HelsinkiHacklab/HugeLedMatrix/KiCad/Absen/physical.dxf

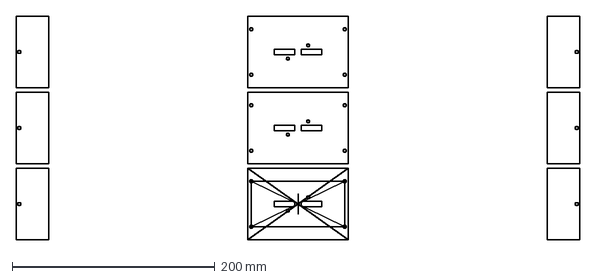
[picture p1: CAD file, 2018-04-18]
KiCad/Absen/physical.dxf
556.0 x 220.4 mm
