HelsinkiHacklab/HugeLedMatrix/KiCad/Absen/absen.pdf

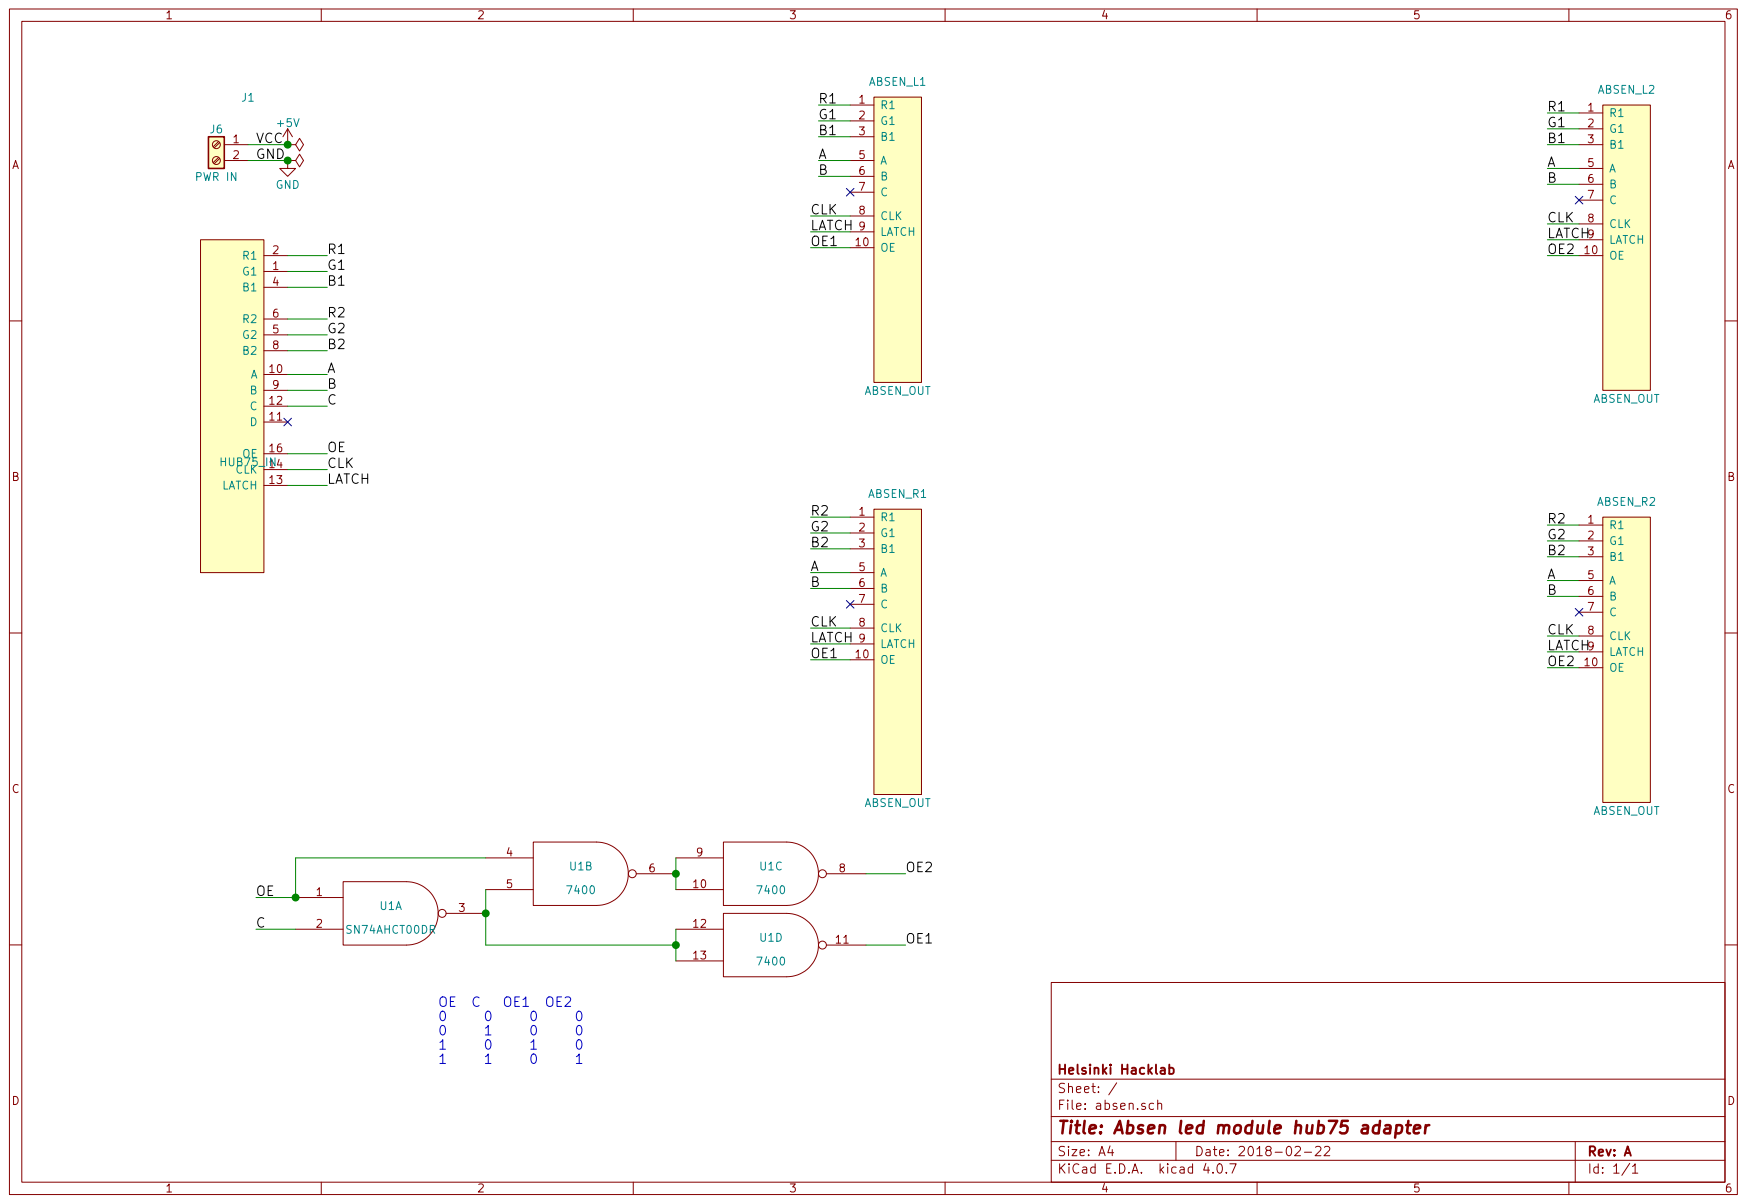
[picture p2: page 1]
