HelsinkiHacklab/HugeLedMatrix/KiCad/Absen/absen.kicad_pcb

## KiCad design KiCad/Absen/absen.kicad_pcb (2018-04-18)

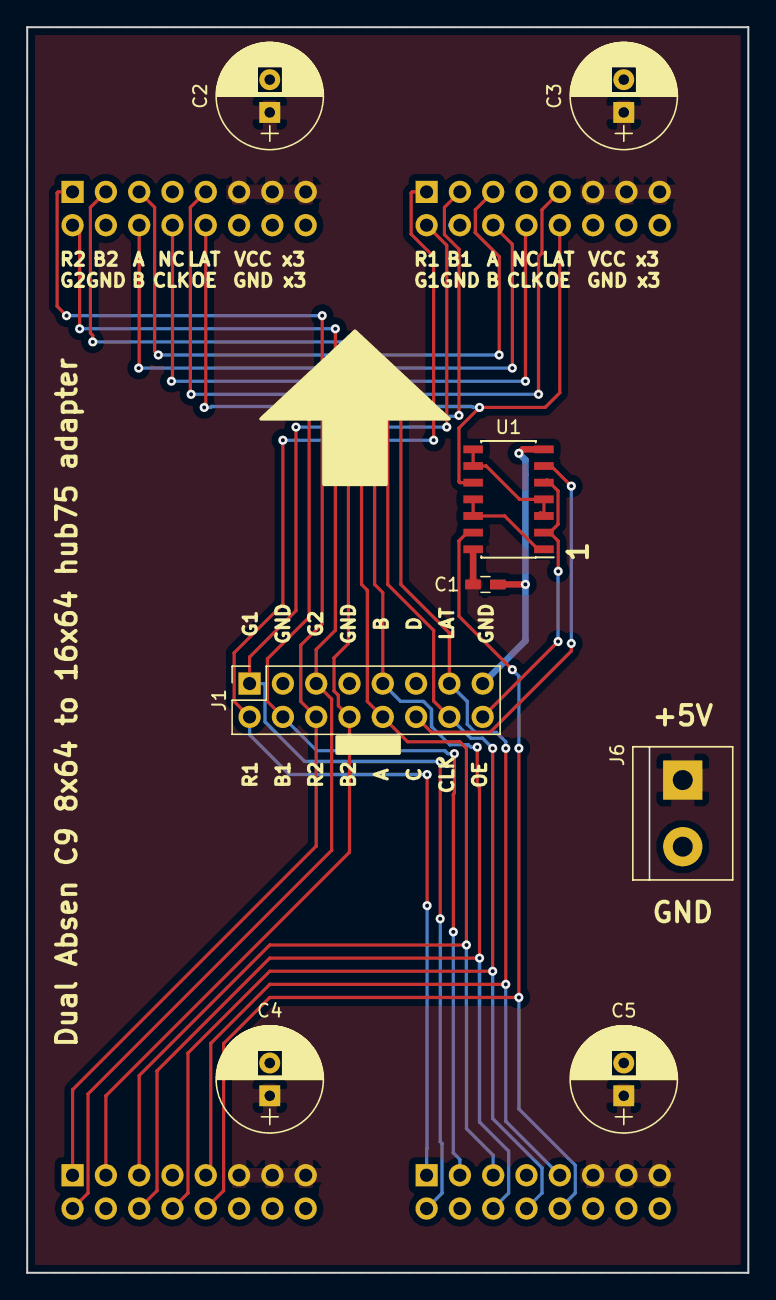
[picture p3: board absen.kicad_pcb from above]

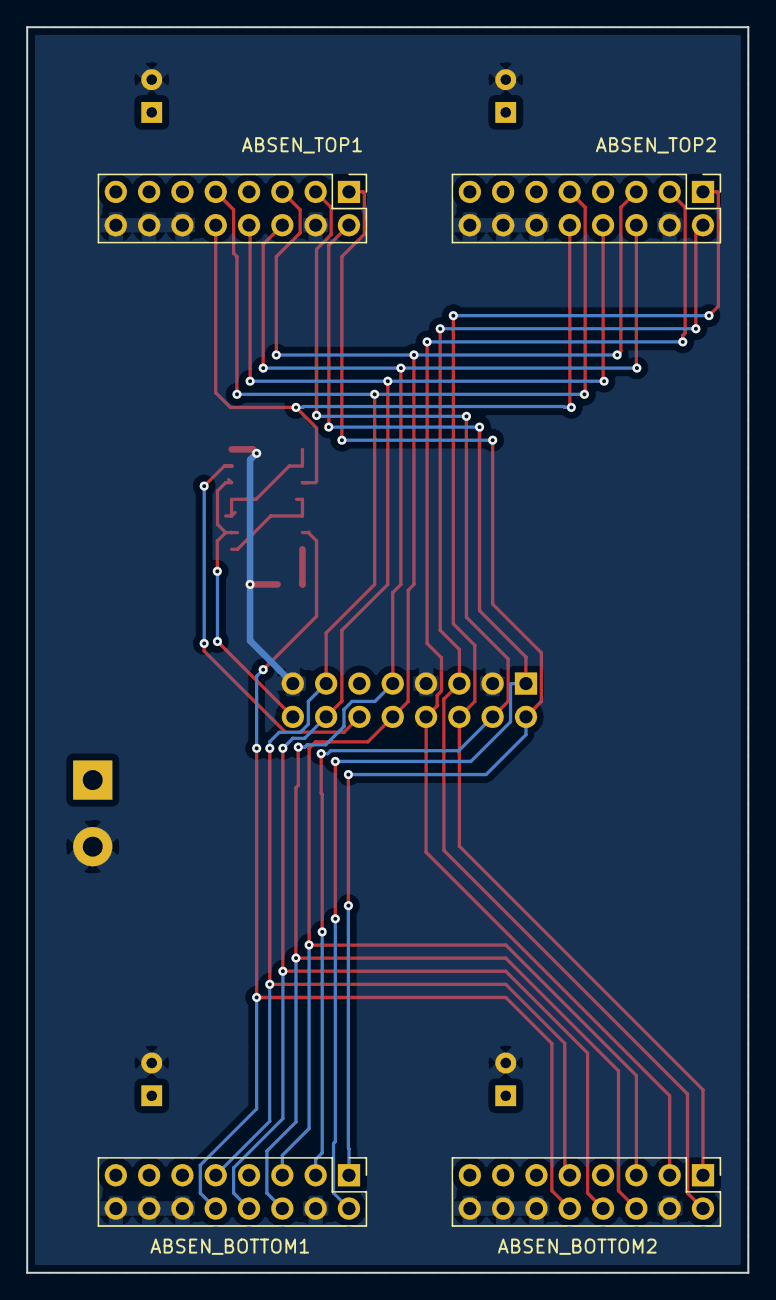
[picture p4: board absen.kicad_pcb from below]

Board: 2 copper layers, 55.0 x 95.0 mm, 12 parts (4 on the bottom side), 18 nets.

Parts:
ABSEN_BOTTOM1, ABSEN_BOTTOM2: ABSEN_OUT; Pin_Header_Straight_2x08_Pitch2.54mm
ABSEN_TOP1, ABSEN_TOP2: ABSEN_OUT; Pin_Header_Straight_2x08_Pitch2.54mm
C1: 100n; C_0603_HandSoldering
C2, C3, C4, C5: CP_Radial_D8.0mm_P2.50mm
J1: HUB75_IN; Socket_Strip_Straight_2x08_Pitch2.54mm
J6: PWR IN; TerminalBlock_bornier-2_P5.08mm
U1: 7402; SOIC-14_3.9x8.7mm_Pitch1.27mm

Connections:
+5V: ABSEN_BOTTOM1.11, ABSEN_BOTTOM1.13, ABSEN_BOTTOM1.15, ABSEN_BOTTOM2.11, ABSEN_BOTTOM2.13, ABSEN_BOTTOM2.15, ABSEN_TOP1.11, ABSEN_TOP1.13, ABSEN_TOP1.15, ABSEN_TOP2.11, ABSEN_TOP2.13, ABSEN_TOP2.15, C1.1, C2.1, C3.1, C4.1, C5.1, J6.1, U1.14
/!OE1: U1.3, U1.4, U1.8, U1.9
/!OE2: U1.1, U1.11, U1.12
/A: ABSEN_BOTTOM1.5, ABSEN_BOTTOM2.5, ABSEN_TOP1.5, ABSEN_TOP2.5, J1.10
/B: ABSEN_BOTTOM1.6, ABSEN_BOTTOM2.6, ABSEN_TOP1.6, ABSEN_TOP2.6, J1.9
/B1: ABSEN_BOTTOM1.3, ABSEN_TOP1.3, J1.4
/B2: ABSEN_BOTTOM2.3, ABSEN_TOP2.3, J1.8
/C: J1.12, U1.6
/CLK: ABSEN_BOTTOM1.8, ABSEN_BOTTOM2.8, ABSEN_TOP1.8, ABSEN_TOP2.8, J1.14
/G1: ABSEN_BOTTOM1.2, ABSEN_TOP1.2, J1.1
/G2: ABSEN_BOTTOM2.2, ABSEN_TOP2.2, J1.5
/LATCH: ABSEN_BOTTOM1.9, ABSEN_BOTTOM2.9, ABSEN_TOP1.9, ABSEN_TOP2.9, J1.13
/OE: J1.16, U1.2, U1.5
/OE1: ABSEN_TOP1.10, ABSEN_TOP2.10, U1.10
/OE2: ABSEN_BOTTOM1.10, ABSEN_BOTTOM2.10, U1.13
/R1: ABSEN_BOTTOM1.1, ABSEN_TOP1.1, J1.2
/R2: ABSEN_BOTTOM2.1, ABSEN_TOP2.1, J1.6
GND: ABSEN_BOTTOM1.4, ABSEN_BOTTOM1.12, ABSEN_BOTTOM1.14, ABSEN_BOTTOM1.16, ABSEN_BOTTOM2.4, ABSEN_BOTTOM2.12, ABSEN_BOTTOM2.14, ABSEN_BOTTOM2.16, ABSEN_TOP1.4, ABSEN_TOP1.12, ABSEN_TOP1.14, ABSEN_TOP1.16, ABSEN_TOP2.4, ABSEN_TOP2.12, ABSEN_TOP2.14, ABSEN_TOP2.16, C1.2, C2.2, C3.2, C4.2, C5.2, J1.3, J1.7, J1.15, J6.2, U1.7
