HelsinkiHacklab/HugeLedMatrix/KiCad/Absen/absen_unrouted.kicad_pcb

## KiCad design KiCad/Absen/absen_unrouted.kicad_pcb (2018-04-18)

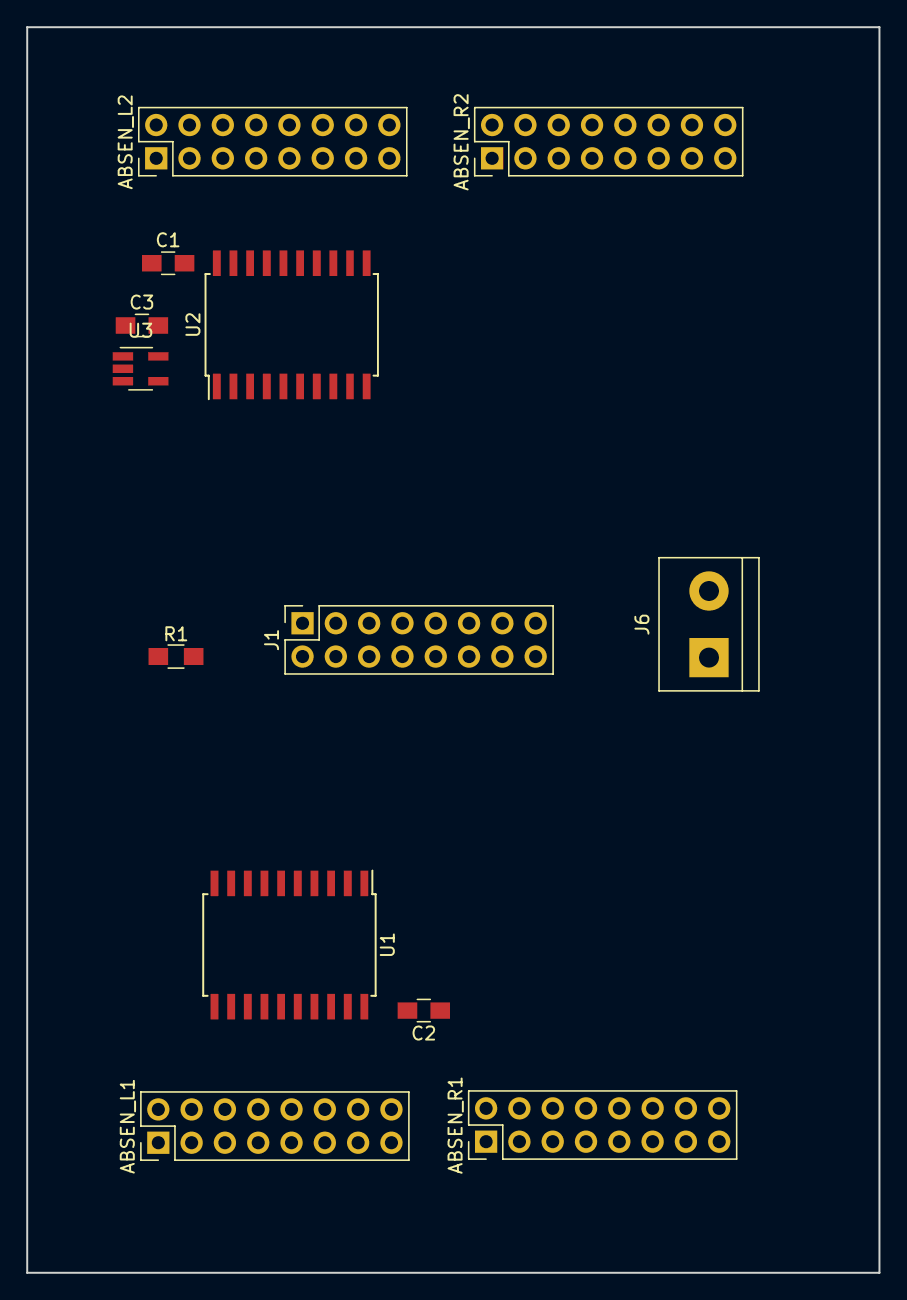
[picture p5: board absen_unrouted.kicad_pcb from above]

Board: 2 copper layers, 65.0 x 95.0 mm, 13 parts (0 on the bottom side), 22 nets.

Parts:
ABSEN_L1, ABSEN_L2: ABSEN_OUT; Pin_Header_Straight_2x08_Pitch2.54mm
ABSEN_R1, ABSEN_R2: ABSEN_OUT; Pin_Header_Straight_2x08_Pitch2.54mm
C1, C2, C3: 100n; C_0805_HandSoldering
J1: HUB75_IN; Socket_Strip_Straight_2x08_Pitch2.54mm
J6: PWR IN; TerminalBlock_bornier-2_P5.08mm
R1: 10k; R_0805_HandSoldering
U1, U2: 74HC245; SOIC-20W_7.5x12.8mm_Pitch1.27mm
U3: 74AHC1G04; SOT-23-5_HandSoldering

Connections:
+5V: ABSEN_L1.11, ABSEN_L1.13, ABSEN_L1.15, ABSEN_L2.11, ABSEN_L2.13, ABSEN_L2.15, ABSEN_R1.11, ABSEN_R1.13, ABSEN_R1.15, ABSEN_R2.11, ABSEN_R2.13, ABSEN_R2.15, C1.2, C2.2, C3.2, J6.1, U1.20, U2.20, U3.5
/A: ABSEN_L1.5, ABSEN_L2.5, ABSEN_R1.5, ABSEN_R2.5, J1.10
/B: ABSEN_L1.6, ABSEN_L2.6, ABSEN_R1.6, ABSEN_R2.6, J1.9
/B1: ABSEN_L1.3, ABSEN_L2.3, J1.4
/B2: ABSEN_R1.3, ABSEN_R2.3, J1.8
/C: J1.12, U1.19, U3.2
/CLK: J1.14, U1.2, U2.2
/CLK1: ABSEN_L1.8, ABSEN_R1.8, U1.18
/CLK2: ABSEN_L2.8, ABSEN_R2.8, U2.18
/G1: ABSEN_L1.2, ABSEN_L2.2, J1.1
/G2: ABSEN_R1.2, ABSEN_R2.2, J1.5
/LATCH: J1.13, U1.3, U2.3
/LATCH1: ABSEN_L1.9, ABSEN_R1.9, U1.17
/LATCH2: ABSEN_L2.9, ABSEN_R2.9, U2.17
/LOW: R1.1, U1.1, U2.1
/OE: J1.16, U1.4, U2.4
/OE1: ABSEN_L1.10, ABSEN_R1.10, U1.16
/OE2: ABSEN_L2.10, ABSEN_R2.10, U2.16
/R1: ABSEN_L1.1, ABSEN_L2.1, J1.2
/R2: ABSEN_R1.1, ABSEN_R2.1, J1.6
GND: ABSEN_L1.4, ABSEN_L1.12, ABSEN_L1.14, ABSEN_L1.16, ABSEN_L2.4, ABSEN_L2.12, ABSEN_L2.14, ABSEN_L2.16, ABSEN_R1.4, ABSEN_R1.12, ABSEN_R1.14, ABSEN_R1.16, ABSEN_R2.4, ABSEN_R2.12, ABSEN_R2.14, ABSEN_R2.16, C1.1, C2.1, C3.1, J1.3, J1.7, J1.15, J6.2, R1.2, U1.10, U2.10, U3.3
unnamed: U2.19, U3.4
